drgdlr09/Bee-Board/BOM.csv

Item | Qty | Supplier | Cost/item | Total Cost | link
ESP32-S3-Zero | 1 | AliExpress | $5.69 | $5.69 | https://www.aliexpress.us/item/3256807067003745.html?src=google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
Kailh Choc V2 Low Profile Switches | 5 | AliExpress | $0.63 | $3.15 | https://www.aliexpress.us/item/3256805913421377.html?curPageLogUid=IvVLKFSRycUZ
Bourns Sliders | 2 | DigiKey | $1.58 | $3.16 | https://www.digikey.com/ordering/shoppingcart
PCB | 1 | JLCPCB | $9.60 | $9.60 | https://cart.jlcpcb.com/shopcart/cart
Estimated total shipping | 1 |  |  | $7.29
