drgdlr09/Bee-Board/Design/Midi_Keyboard.kicad_pcb

## KiCad design Design/Midi_Keyboard.kicad_pcb (2026-10-28)

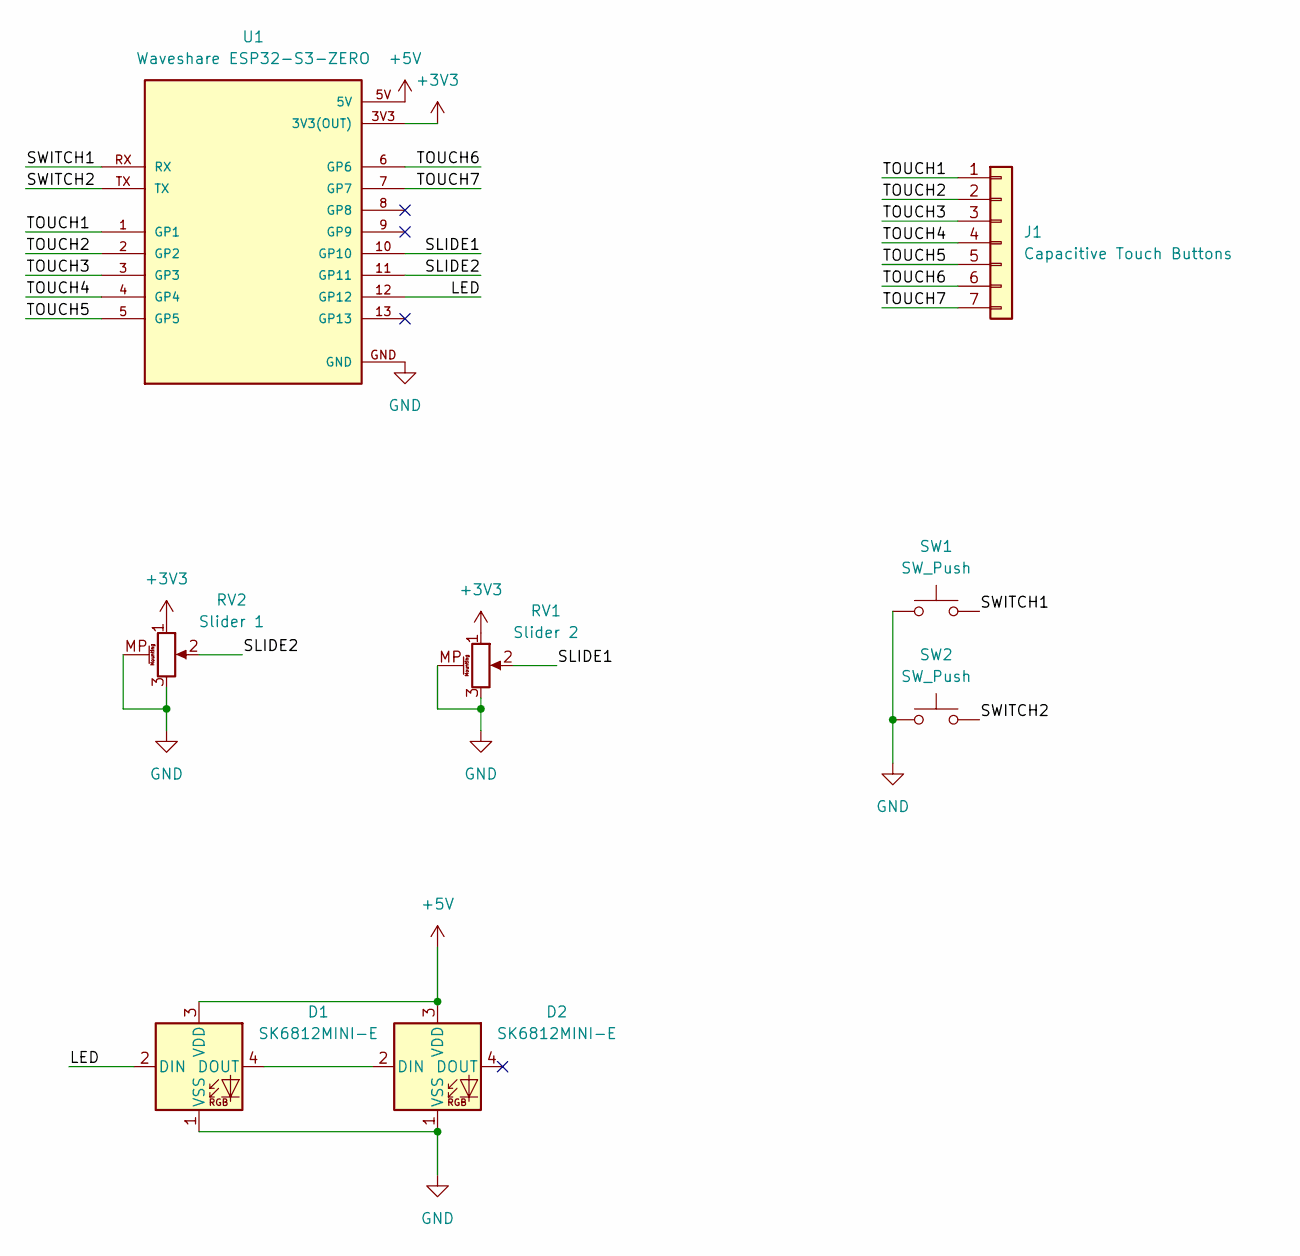
[picture p1: schematic Midi_Keyboard.kicad_sch]

Parts:
D1, D2: SK6812MINI-E; LED_SK6812MINI-E_3.2x2.8mm_P1.5mm_ReverseMount
J1: Capacitive Touch Buttons; Touch_Honeycomb_7
RV1: Slider 2; Potentiometer_Bourns_PTA1543_Single_Slide
RV2: Slider 1; Potentiometer_Bourns_PTA1543_Single_Slide
SW1, SW2: SW_Push; Kailh Choc Low-Profile Switches
U1: Waveshare ESP32-S3-ZERO; Waveshare ESP32-S3-Zero; PARTREV NA

Connections:
+3V3: RV1.1, RV2.1, U1.3V3 (3V3(OUT))
+5V: D1.3 (VDD), D2.3 (VDD), U1.5V
GND: D1.1 (VSS), D2.1 (VSS), RV1.3, RV1.MP (MountPin), RV2.3, RV2.MP (MountPin), SW1.1, SW2.1, U1.GND
LED: D1.2 (DIN), U1.12 (GP12)
N$D1.4_D2.2: D1.4 (DOUT), D2.2 (DIN)
SLIDE1: RV1.2, U1.10 (GP10)
SLIDE2: RV2.2, U1.11 (GP11)
SWITCH1: SW1.2, U1.RX
SWITCH2: SW2.2, U1.TX
TOUCH1: J1.1, U1.1 (GP1)
TOUCH2: J1.2, U1.2 (GP2)
TOUCH3: J1.3, U1.3 (GP3)
TOUCH4: J1.4, U1.4 (GP4)
TOUCH5: J1.5, U1.5 (GP5)
TOUCH6: J1.6, U1.6 (GP6)
TOUCH7: J1.7, U1.7 (GP7)

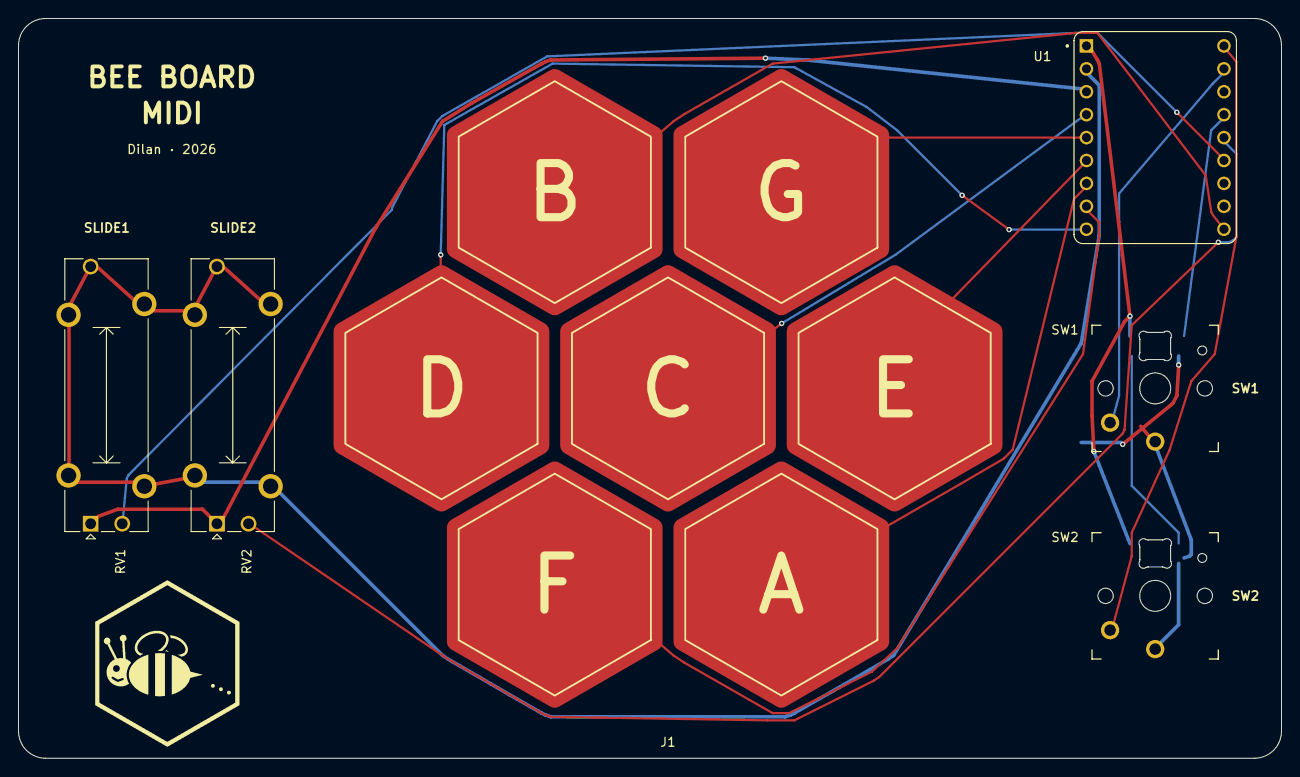
[picture p2: board Midi_Keyboard.kicad_pcb from above]

Board: 2 copper layers, 140.0 x 82.0 mm, 9 parts (0 on the bottom side), 16 nets.

Other parts of the board:
G1: Bee_Logo
