drgdlr09/Bee-Board/JOURNAL.md

# Bee Board: devlog

<!-- Generated by Half Life from project cmvfkz082007a01rplw6y48i4. Edits here are overwritten on the next sync. -->
<!-- Generated: 2026-10-24T19:17:52.014Z -->

> [!NOTE]
> This devlog is mirrored from [Half Life](https://halflife.hackclub.com) ([open the project](https://halflife.hackclub.com/projects/cmvfkz082007a01rplw6y48i4)). Editing it here will not change the platform's copy, and the next sync overwrites this file.

> A musical tool with 7 copper pads, 2 switches to adjust the octave, and 2 sliders to adjust volume and modulation.

| Week | Tier | Hours logged | Entries |
| --- | --- | --- | --- |
| Week 3 | Tier 1 | 7h | 2 |

## Contents

1. [2026-10-22: # October 21, 22: Designing Schematic and Filling Out BOM](#2026-10-22-october-21-22-designing-schematic-and-filling-out)
2. [2026-10-24: October 23: Designing The PCB](#2026-10-24-october-23-designing-the-pcb)

## Design

### 2026-10-22: # October 21, 22: Designing Schematic and Filling Out BOM

**3h**

# October 21, 22: Designing Schematic and Filling Out BOM

Okay, so I finally got started on my Midi Keyboard project. This is the first time I've done one of the starter projects, and so far I have to say things are going well.

The first thing I worked on was the schematic. I had a bit of trouble importing the symbols and footprints libraries, but once I got them in I followed the tutorial and finished a solid layout with 2 buttons to adjust the octave and 2 sliders to adjust volume and modulation. I'm a bit of a perfectionist, so I took the time to carefully align each of the components and labels so I can have it the way I like. In my first design, I used the XIAO ESP32-S3, but I restarted so I could use the Waveshare ESP32-S3-ZERO so I could get some more pins.I thought I wouldn't be able to add the LEDs due to budget constraints, but it turns out that I actually have some leftover from a keyboard repair I did a couple months ago! I added a few to the schematic to finalize it.

Screenshot 2026-10-23 at 7.43.41 PM

Screenshot 2026-10-23 at 7.43.57 PM

The next thing I did was get started on the Bill of Materials. With taxes and shipping included, I'd definitely be cutting it close to the $30 budget, so I visited multiple sites like AliExpress, LCSC, Amazon, and DigiKey to compare prices and find the cheapest components. I settled to get the ESP32-S3-ZERO and switches from AliExpress, and the sliders from DigiKey. I also need to add the PCB costs to the BOM once I finish, but I think it'll be within the budget.

Screenshot 2026-10-23 at 7.44.31 PM

Screenshot 2026-10-23 at 7.45.27 PM

Next, I'll need to start designing the PCB and routing the board, and after that I need to do the firmware.

# TL;DR: I finished the schematic and most of the BOM for my Midi Keyboard. I took my time with the schematic to get everything the way I want it, but I may need to change some stuff around when I actually design my PCB. For the BOM, I specifically searched for the components with the cheapest prices to fit in the budget.

### 2026-10-24: October 23: Designing The PCB

**4h**

October 23: Designing The PCB

Today I finished designing the PCB for my midi keyboard. With all my components already laid out on the PCB design screen, all I needed to do was decide how the touch pads will look. This is the most important part of the project in my opinion, because it'll decide how the board will look and its theming. I was debating between the standard piano keys, xylophone bars, and simple circles, but I ultimately decided on hexagonal touch pads. To me, they kind of look like honeycomb, so I renamed my project the Bee Board!

Screenshot 2026-10-24 at 3.13.10 PM

Screenshot 2026-10-24 at 3.13.51 PM

Screenshot 2026-10-24 at 3.14.14 PM

The board is 140mm x 82mm and it has 2 layers (front and back). Another design choice I made was to round out the corners, which I had to research how to do, to make the Bee Board easier to hold.

Routing is always the most difficult part of designing a PCB. I had to redo my traces a couple times to get it the way I wanted. I made it pretty smooth so the traces flow around the touch pads and other components.

Screenshot 2026-10-24 at 3.17.11 PM
To finish off the PCB, I put some text in the top left corner and a simple bee icon in the bottom left.

Next, I'll need to work on the firmware, which might take a while.

# tl;dr: I finished designing my PCB for the midi keyboard. I decided to use a honeycomb design for the touchpads, I I named my project the Bee Board! I added my name in the top left corner and a bee icon in the bottom left to finalize the design.
