drgdlr09/Bee-Board/(commit log)

2026-10-28 Revise README with detailed project functionality
    Updated the description of the Bee Board project, including details about the touch pads, sliders, and switches functionality.
2026-10-28 Enhance README with Bee Board project details
    Added detailed descriptions of the Bee Board's features, components, and functionality, including MIDI control and touchpad specifications.
2026-10-28 Sync Bee Board from Half Life
2026-10-28 Add PCB entry to the components list in README
